EddieOhlson/ucg-ultra-rack-mount/README.md

# UCG-Ultra 1U Rack Mount

A 3D-printable 1U, 19" rack mount for the UniFi **Cloud Gateway Ultra (UCG-Ultra)**, with:

- A diamond-mesh front grille with an opening for the gateway's display
- A bay for a 5015 USB blower fan that pushes air through a channel under the gateway
- 5 keystone cut-outs (labelled 1, 2, 3, 4, WAN) for user-supplied keystone jacks
- A front-panel master switch: a 16 mm illuminated push button that turns the UCG-Ultra and fan on and off together, lit when on
- Patch-cable zip-tie anchors and a hook-and-loop strap to hold the gateway
- A two-piece body joined by a splice bracket, so each part fits a 220 × 220 mm bed

The design is fully parametric (Python + [manifold3d](https://github.com/elalish/manifold)).

> **Also in this repo:** a modular version with the UCG-Ultra in one half-width module and a UniFi USW-Ultra PoE switch in the other. See [half-modules/](half-modules/).

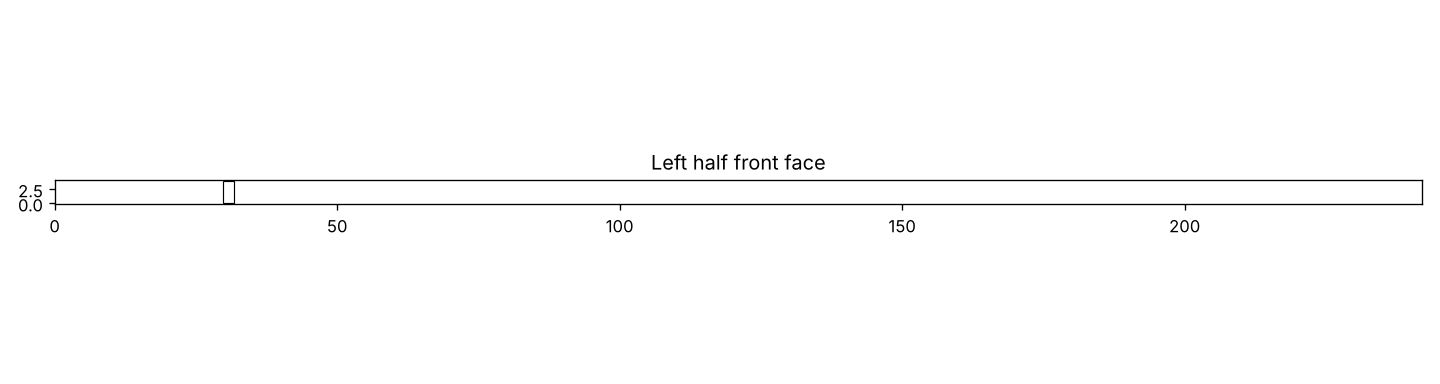
[picture p1: docs/front_grille.png]
Front grille

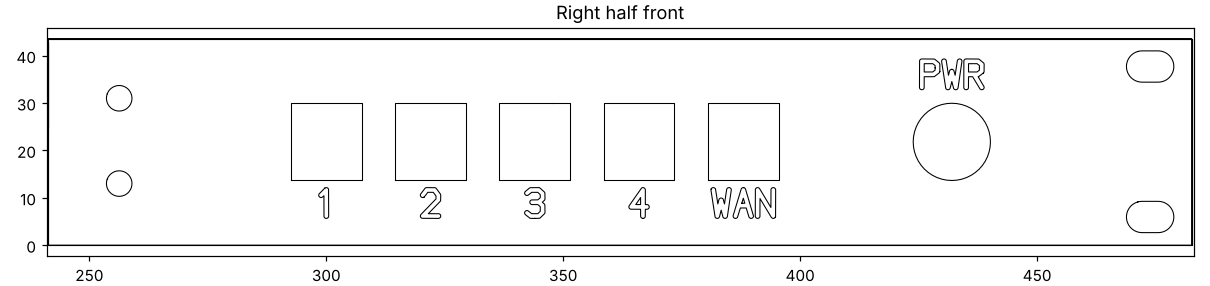
[picture p2: docs/right_half.png]
Right half

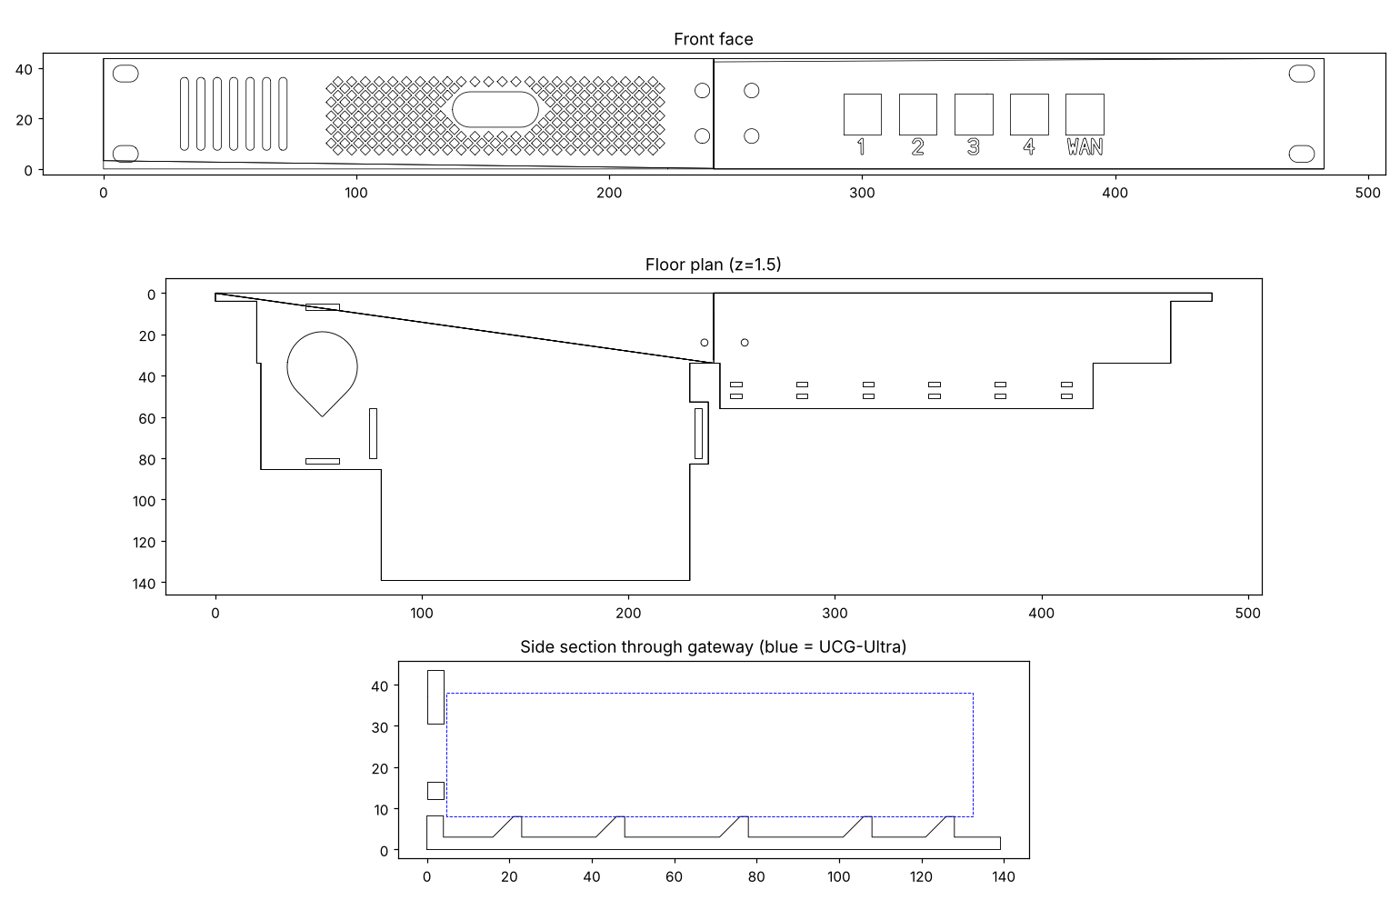
[picture p3: docs/sections.png]
Sections


## Files

| File | What it is |
|---|---|
| `stl/UCG-Ultra_rack_LEFT.stl` | Left half: ear, fan bay, gateway tray, mesh grille |
| `stl/UCG-Ultra_rack_RIGHT.stl` | Right half: keystones, master power switch, cable anchors, ear |
| `stl/UCG-Ultra_rack_SPLICE.stl` | Bracket that joins the two halves |
| `ucg_rack.py` | Parametric source; re-run to regenerate the STLs into `out/` |
| `docs/render_sections.py` | Draws section views for checking changes |

The STLs are already in print orientation: front face down, turned 45° to fit a 220 mm bed (tested for the Flashforge Adventurer 5M).

## Parts list

Amazon links for every part are in [PARTS.md](PARTS.md).

### Electronics
| Qty | Part | Notes |
|---|---|---|
| 1 | 5015 blower fan, 5 V USB | 50 × 50 × 15 mm |
| 1 | 16 mm latching push button, 5 V LED, 3 A+ | Master on/off switch on the front panel |
| 1 set | USB-C male + female breakout boards with screw terminals (with CC pins) | Put the switch in the UCG-Ultra's power line |
| 1 | USB-A female screw-terminal adapter | Powers the fan from the same switched 5 V |
| 5 | Cat6 keystone jacks | Standard size |
| 5 | Cat6 patch cables, 0.3 m (1 ft) | Slim cables bend more easily |

### Hardware
| Qty | Part | Notes |
|---|---|---|
| 8 | M3 heat-set inserts, ~4 mm long | Go in the splice bracket (4.1 mm holes) |
| 8 | M3 × 8 mm countersunk screws (DIN 7991) | 4 through the front panel, 4 through the floor |
| 4 | M6 cage nuts and screws | Usually included with the rack |
| 4 | M6 washers | Under the rack screws, to protect the plastic |

### Ties and straps
| Qty | Part | Notes |
|---|---|---|
| 1 | Zip tie, 200 mm or longer | Holds the fan |
| 7 | Small zip ties, 4.8 mm wide or narrower | Patch-cable anchors |
| 1 | Hook-and-loop strap, 20 mm wide or less, ~45 cm | Holds the gateway |

### Printing
| Qty | Part | Notes |
|---|---|---|
| ~300 g | PETG filament | Preferred over PLA for heat and creep resistance |

## Printing

- **Material:** PETG
- **Walls:** 4. Infill 20–30%.
- **Bed:** textured PEI with a thin layer of glue stick as release, plus a brim
- **Elephant's foot compensation:** ~0.15 mm, so the keystone holes aren't tight at the front
- **Avoid crossing walls:** on, to stop strings across the mesh
- **Bridges:** ~25 mm/s with full fan
- **Supports:** none needed

Before the full print, test-print a small slice with the display opening and one keystone hole to check the fit.

## Assembly

1. Press the 8 heat-set inserts into the splice bracket (~220–230 °C).
2. Butt the two halves together, then fit the bracket behind the seam with 8 × M3 × 8 countersunk screws.
3. Snap the keystone jacks into the right half from behind.
4. Mount the push button through the 16 mm hole, tighten its nut from behind, and wire it into the UCG-Ultra's USB-C power line as shown in [PARTS.md](PARTS.md#wiring-the-master-switch). The fan is powered from the same switched line.
5. Put the fan in its bay with the outlet facing the gateway, and secure it with the long zip tie. Route its cable through the notch in the rear wall.
6. Drop the gateway into the tray, display facing the grille, and strap it down.
7. Connect the patch cables from the gateway's rear ports to the keystones, and tie them to the anchors.
8. Install the gateway before racking, or leave the U above it empty, because it drops in from the top.
9. Rack it with M6 screws and washers.

## Customising

Edit the parameters at the top of `ucg_rack.py` and run it:

```bash
pip install manifold3d trimesh numpy
python3 ucg_rack.py
```

| Parameter | What it controls |
|---|---|
| `GX` | Where the gateway sits across the panel |
| `CLR` | Clearance around the gateway |
| `RISE` | Air channel under the gateway |
| `KS_W`, `KS_H`, `KS_WALL` | Keystone cut-out size and wall thickness at the clip |
| `KS_LABELS` | Port labels |
| `DISP_W`, `DISP_H`, `DISP_Z` | Display opening size and height |
| `DIA`, `RIB` | Diamond size and rib width |
| `FAN`, `FAN_H` | Fan pocket size |
| `SW_X`, `SW_Z`, `SW_HOLE` | Power switch position and hole size |

## Reference dimensions

- **UCG-Ultra:** 141.8 × 127.6 × 30 mm (Ubiquiti datasheet)
- **Panel:** 482.6 × 43.6 mm (1U minus 0.85 mm clearance), EIA ear holes at 465.1 mm centres
- **Depth behind the rails:** 139 mm (about 180 mm including cables). Fits racks 9" (229 mm) deep or more.

## Notes

This is an original design, not a copy of any commercial product. UniFi and UCG-Ultra are trademarks of Ubiquiti Inc.
