EddieOhlson/ucg-ultra-rack-mount/half-modules/stl/UCG_module.stl

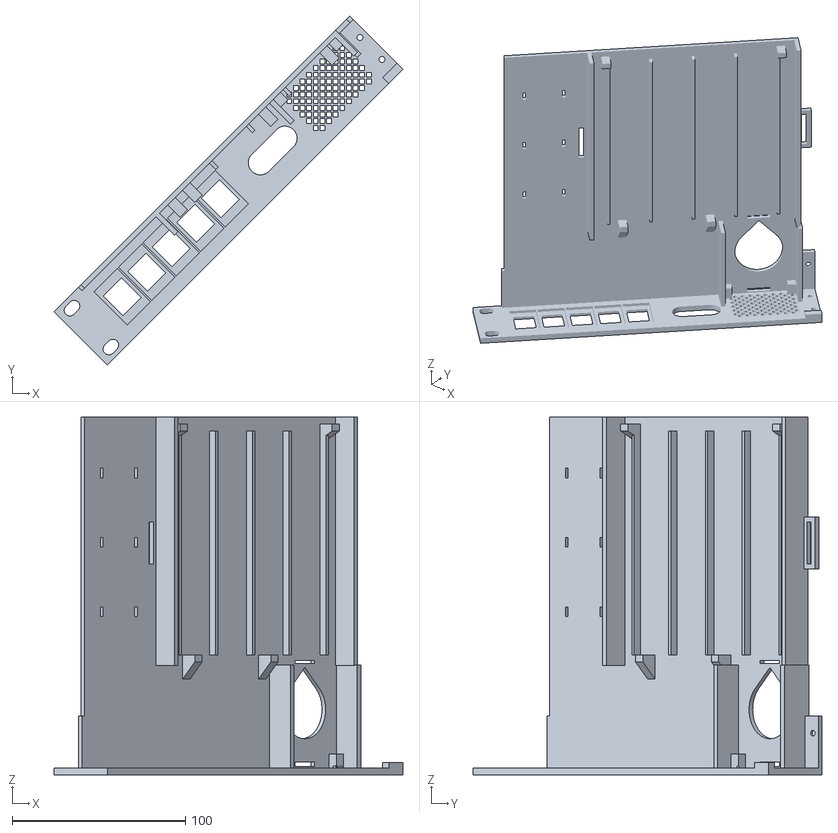
[picture p6: CAD file, 2026-11-01]
half-modules/stl/UCG_module.stl
201.5 x 201.5 x 206.4
