EddieOhlson/ucg-ultra-rack-mount/stl/UCG-Ultra_rack_RIGHT.stl

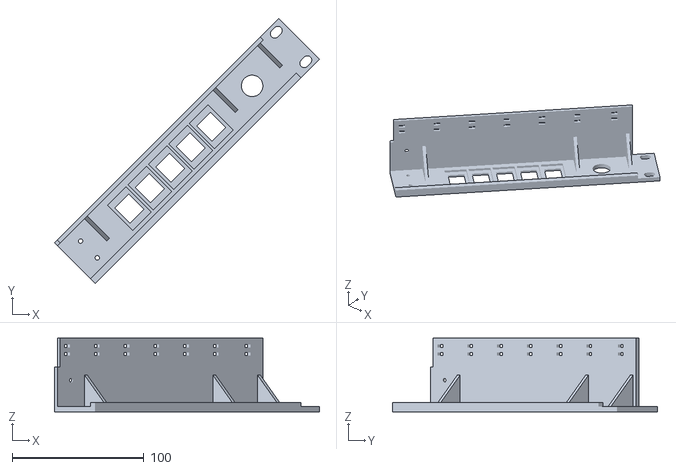
[picture p7: CAD file, 2026-11-01]
stl/UCG-Ultra_rack_RIGHT.stl
201.5 x 201.5 x 56.0
