EddieOhlson/ucg-ultra-rack-mount/half-modules/stl/USW_module.stl

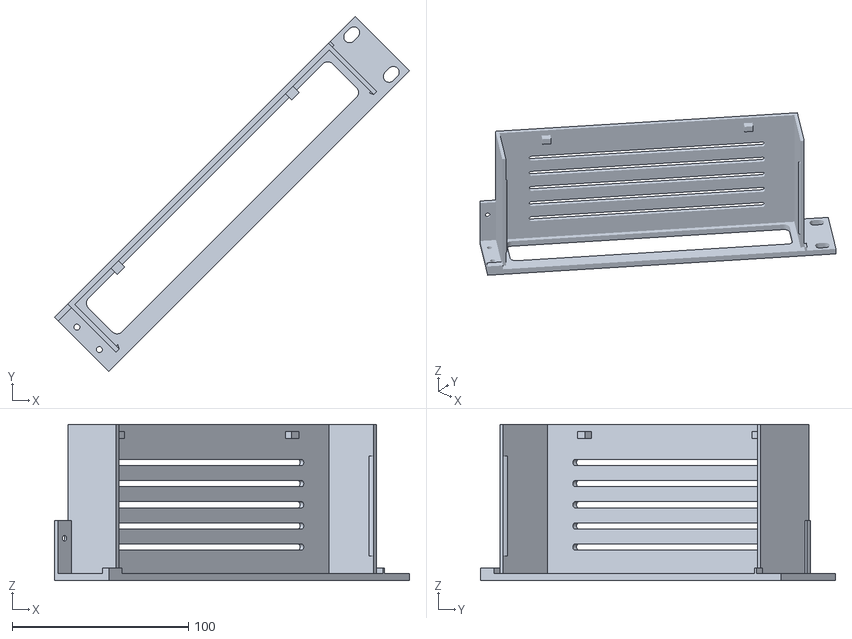
[picture p8: CAD file, 2026-11-01]
half-modules/stl/USW_module.stl
201.5 x 201.5 x 88.6
