EddieOhlson/ucg-ultra-rack-mount/stl/UCG-Ultra_rack_LEFT.stl

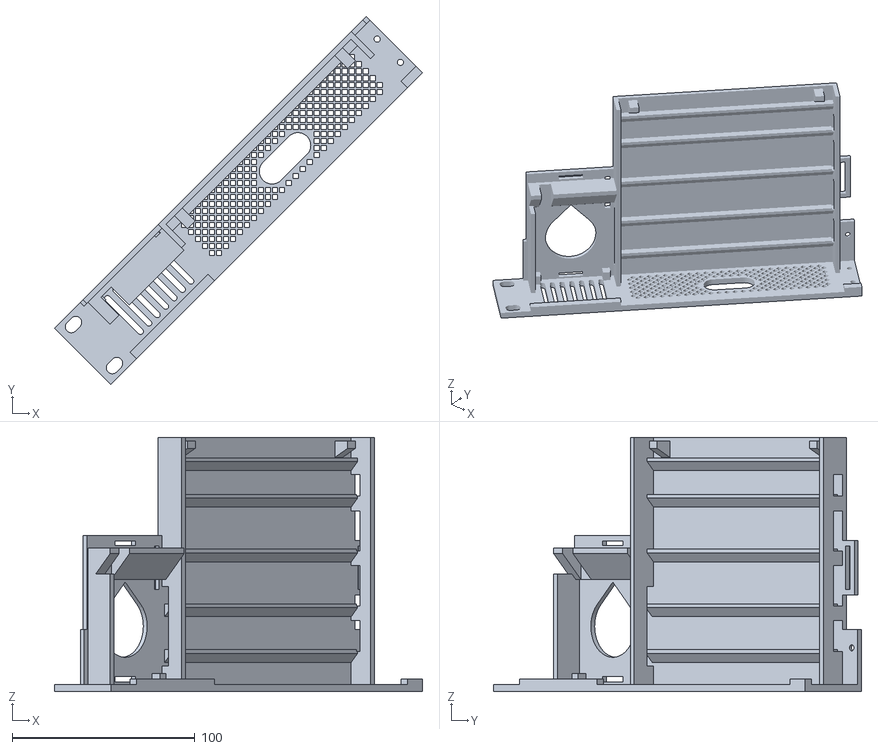
[picture p9: CAD file, 2026-11-01]
stl/UCG-Ultra_rack_LEFT.stl
201.5 x 201.5 x 139.2
