EddieOhlson/ucg-ultra-rack-mount/half-modules/stl/SPLICE.stl

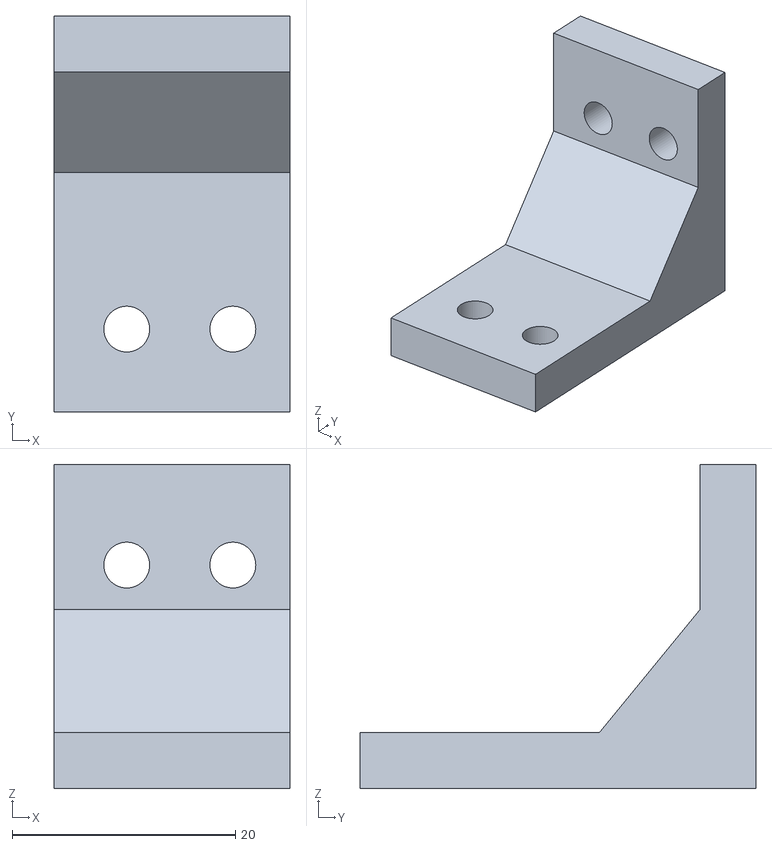
[picture p10: CAD file, 2026-11-01]
half-modules/stl/SPLICE.stl
21.1 x 35.4 x 29.0
