EddieOhlson/ucg-ultra-rack-mount/stl/UCG-Ultra_rack_SPLICE.stl

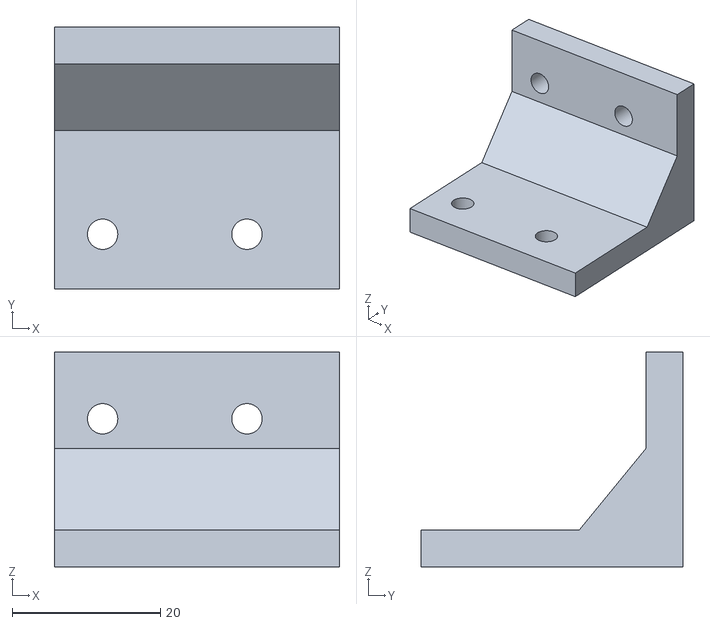
[picture p11: CAD file, 2026-11-01]
stl/UCG-Ultra_rack_SPLICE.stl
38.5 x 35.4 x 29.0
