EddieOhlson/ucg-ultra-rack-mount/(commit log)

2026-11-01 UCG-Ultra 1U rack mount: STLs, parametric source, parts list
    Claude-Session: https://claude.ai/code/session_017XzmeVPShyJgRuAWq8fDGn
    [UCG-Ultra_rack_LEFT.stl, UCG-Ultra_rack_RIGHT.stl, UCG-Ultra_rack_SPLICE.stl]
2026-11-01 Add front-panel fan on/off switch (16 mm illuminated push button)
    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
    [UCG-Ultra_rack_LEFT.stl, UCG-Ultra_rack_RIGHT.stl]
2026-11-01 Make the front switch a master switch for UCG-Ultra and fan
    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
    [UCG-Ultra_rack_RIGHT.stl]
2026-11-01 Add modular version: UCG-Ultra module + USW-Ultra PoE switch module
    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
    [SPLICE.stl, UCG_module.stl, USW_module.stl]
2026-11-01 Modular version: drop power button, UCG module gets 5 front keystones
    Gateway set back 66 mm so the keystones and patch-cable plugs fit in
    front of it; fan moved in front of the gateway, blowing under it.
    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
    [UCG_module.stl, USW_module.stl]
